amrmahgoub/Two-Wheel-Self-Balancing-Robot/README.md

# Two-Wheels-Self-Balancing-Robot
Created a two-wheeled balancing robot with IMU MPU 6050, Cytron motor drive, and Arduino Uno. IMU tracks orientation, motor drive adjusts speed for balance, Arduino runs PID algorithm. Project included design, assembly, and PID implementation.
